iango94/Electrocardiografia1/DocumentosAdicionales/Presentacion.pptx

## Slide 2

## ECG sin filtros externos (centrado a la media)

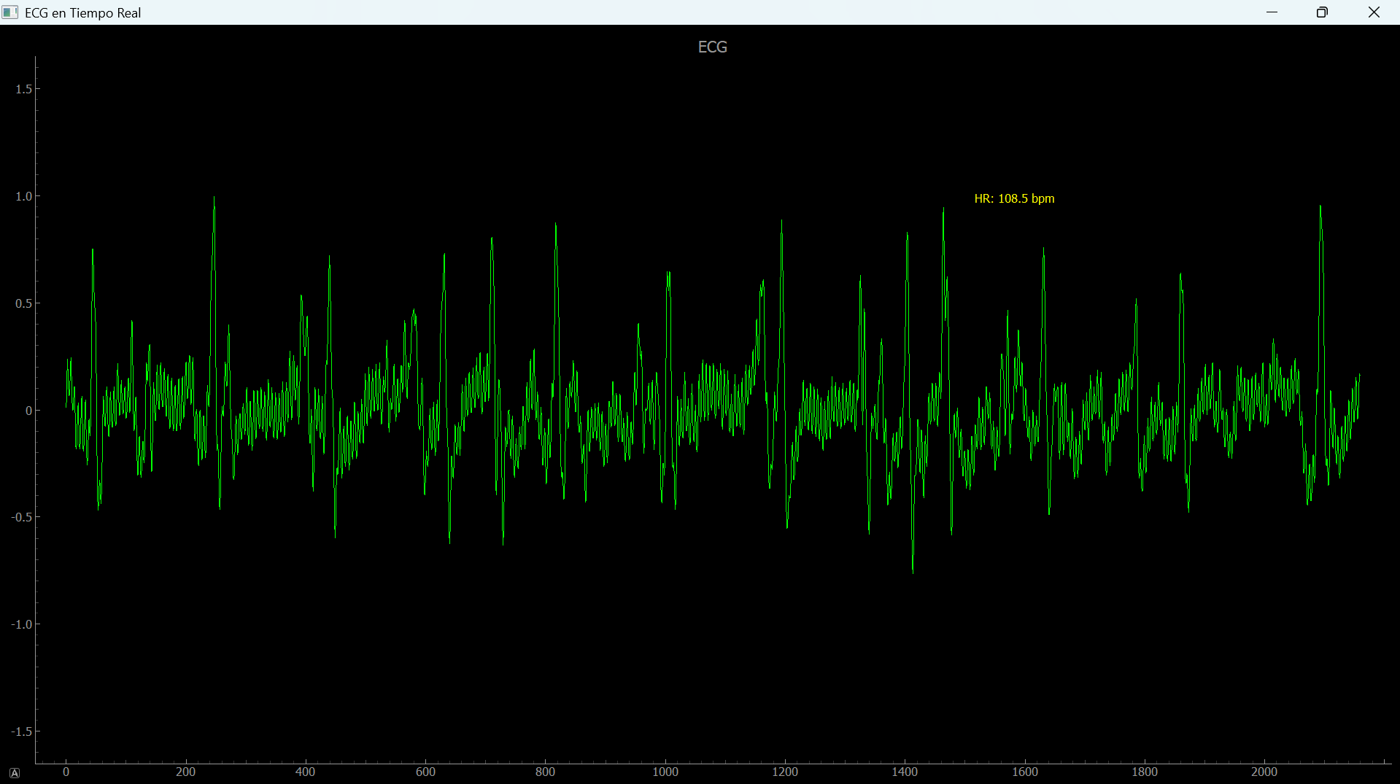
[picture p1: figure]

Derivación I

## Sin filtros de software (centrado a la media)

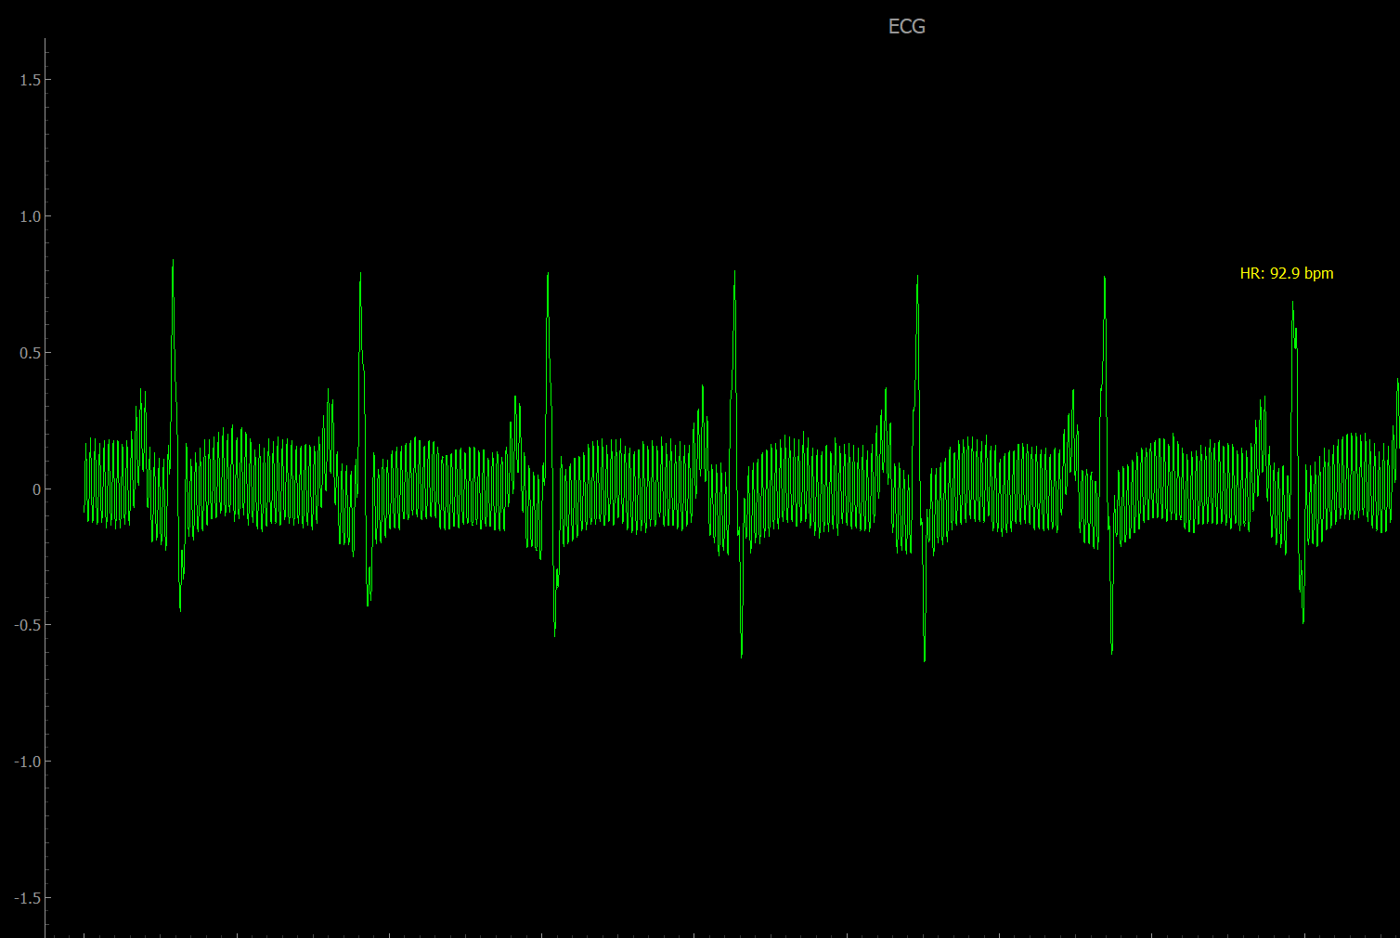
[picture p2: figure]

Derivación I

## ECG front-end (AD8232)

- Amplificador de instrumentación 1:1000
- Filtro de modo común
- Filtro pasabanda (0,5-50Hz)
- Salida analógica (0-3.3V)

## Arduino Nano

- Placa de desarrollo programable
- Convertidor analógico-digital
- Interfaz serial con PC (USB)
- Envía los voltajes analógicos de 0-3,3v de salida del AD8232, al PC 360 veces por segundo como un entero positivo entre 0-1023 (10 bits)

## Slide 7

## Procesamiento en software

1. Se recibe la señal por el puerto serie
2. Se realiza un filtro digital pasa-altas con corte en 0.5Hz (elimina ruido muscular y reparación)
3. Se realiza un filtro digital pasa-bajas con corte en 50Hz (elimina ruido AC y radiofrecuencias)
4. Se normaliza a la media (centra los valores en el promedio acumulado de las medidas)
5. Se analiza la onda para encontrar picos y calcular FC e intervalos.
6. Se grafican los valores digitales (voltajes instantáneos) en el tiempo como una línea continua (simulando la lectura analógica).
7. OPCIONAL: Se imprime la señal en una cuadricula estandarizada, se indica la FC e intervalos; y se guarda como PDF.

## Posición electrodos para derivación I (ECG 3E)

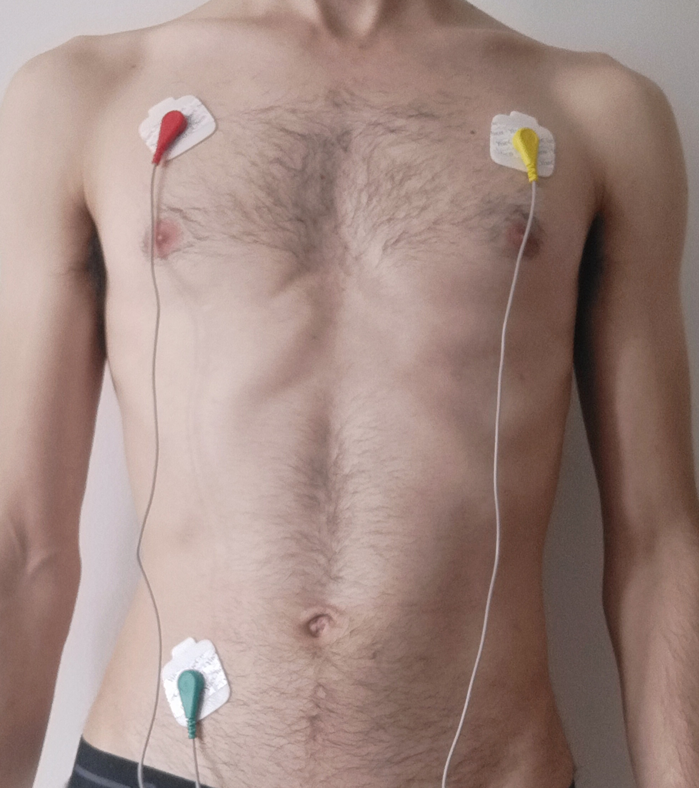
[picture p3: figure]

- Verde: Equipotencialización y modo común.
- Rojo: Electrodo (-)
- Amarillo: Electrodo (+)
- Para la demostración usamos la derivación II (ECG 3E)
EL CIRCUITO TIENE COMO SALIDA LA DIFERENCIA DE VOLTAJES ENTRE LOS ELECTRODOS ROJO Y AMARILLO, DESPUES DE AMPLIFICADA.

## Salida derivación II con todos los filtros

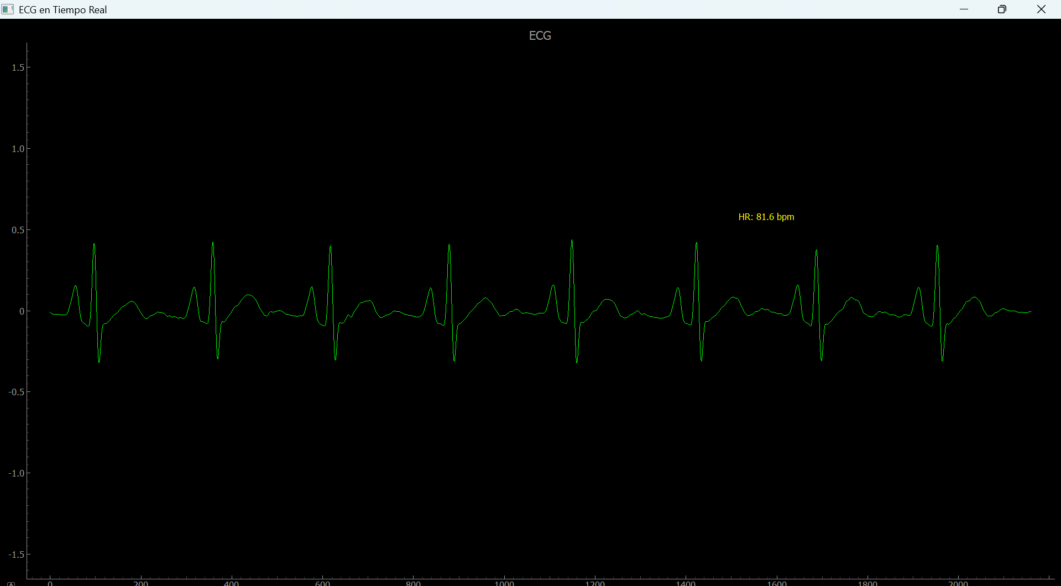
[picture p4: figure]

Derivación II

## Salida derivación II en cuadricula estandar

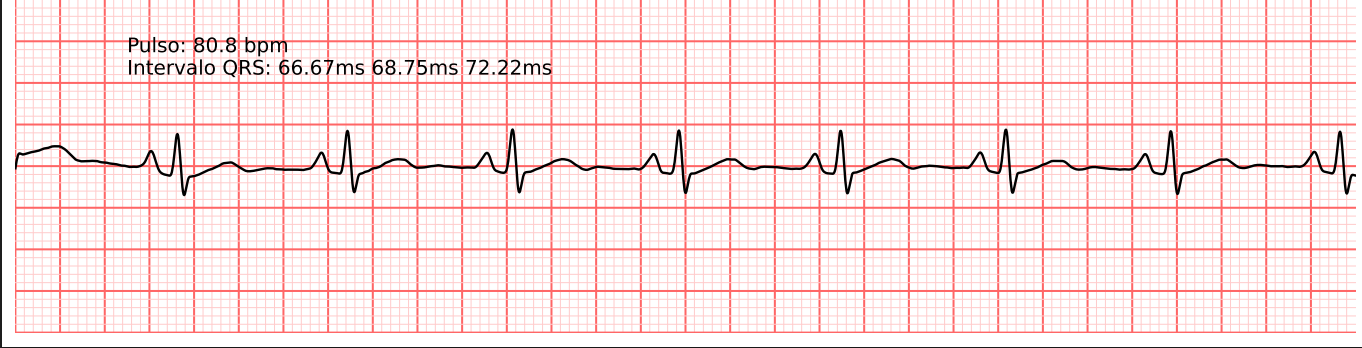
[picture p5: figure]

Derivación II

## Slide 12

## La importancia electrocardiograma

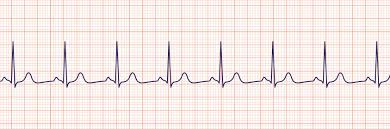
[picture p6: figure]

ECG Normal: ritmo sinusal

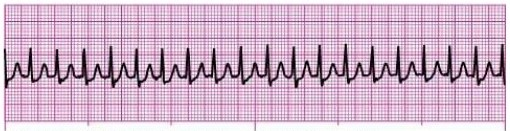
[picture p7: figure]

Taquicardia Supraventricular

- Estos 2 ritmos tienen los mismos síntomas (cuando el paciente esta consiente).
- La taquicardia supraventricular es una urgencia medica normalmente benigna.
- Torsades de Points es un ritmo mortal en cuestión de minutos.

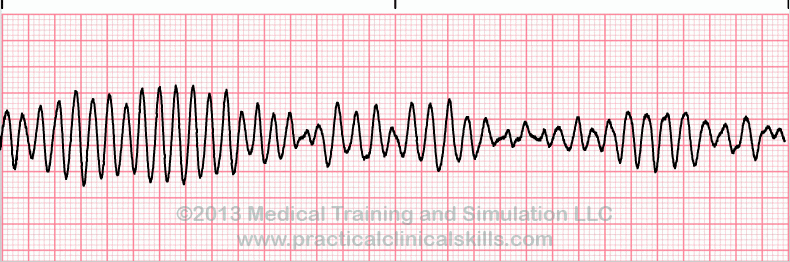
[picture p8: figure]

Torsades de Pontes (V-tac)
