iango94/Electrocardiografia1/ECG_Presentacion final tentativa.pdf

Problemática (Hanna)

- Principal causa de Muerte
- Muchas prevenibles con atención medica oportuna y tratamiento prehospitalario adecuado
- Mencionar los objetivos y el RDS.
- Solución de problemas (tema secundario)

Diseño analógico (Laura)

- Que es el ECG y que representa una derivación.
- Pasos:
- Restar potenciales
- Amplificar
- Filtrar
- Volver a amplificar
- Convertir a digital
- Casos especiales:
- WCT: promedio de RA, LA y LL, punto isoeléctrico para precordiales.
- RLD: cancelación activa de ruido y referencia a tierra.

Diseño digital y software (Ian)

- Conversión analógica digital
- Captura de datos (ECG + Cuestionario)
- Delineación del ECG (el algoritmo de Pan-Tompkins y sus mejoras)
- Algoritmo infartos AHA

Problema 1: (Angel)

- Señal vs ruido

Problema 2: (Camilo)

- Deriva de línea base (respiración + potencial de media celda)

Conclusiones (Alejandro)
