iango94/Electrocardiografia1/esquematicosCircuitos/Imagen_DerivacionII.png

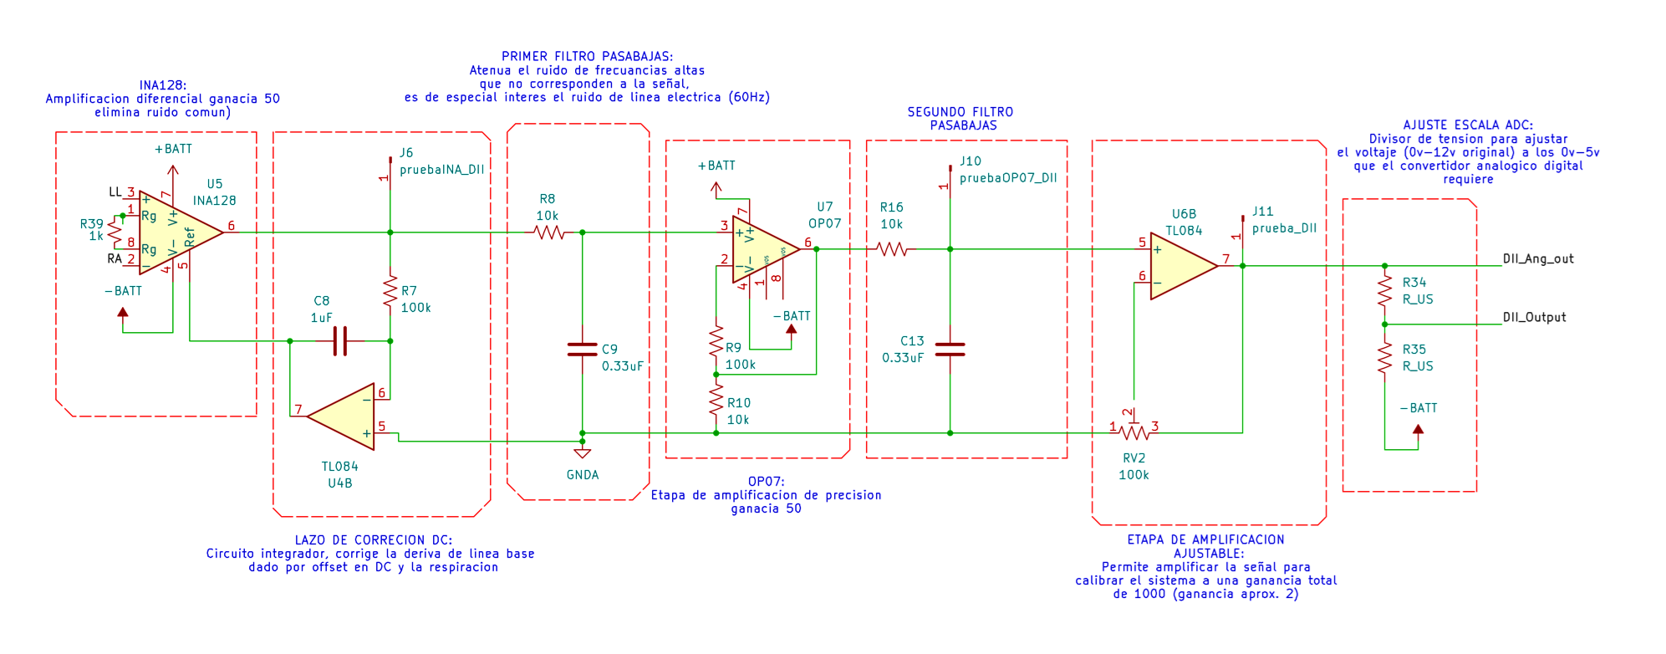
esquematicosCircuitos/Imagen_DerivacionII.png
