iango94/Electrocardiografia1/ECGs/ReporteECG_PresentacionClase.pdf

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

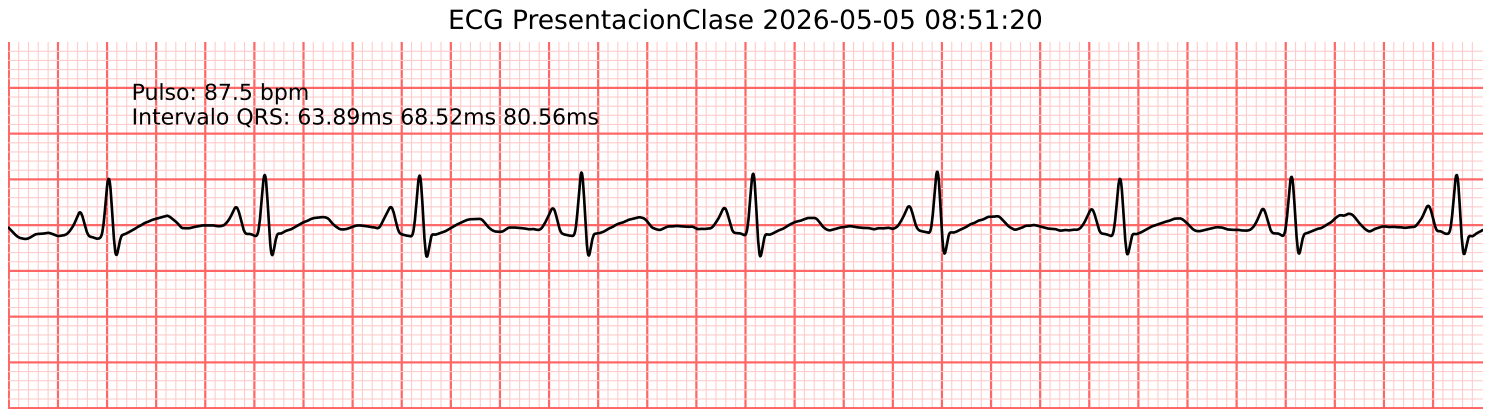
[picture p10: page 1]
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
