iango94/Electrocardiografia1/esquematicosCircuitos/Esquematico_DII_subsucciones.pdf

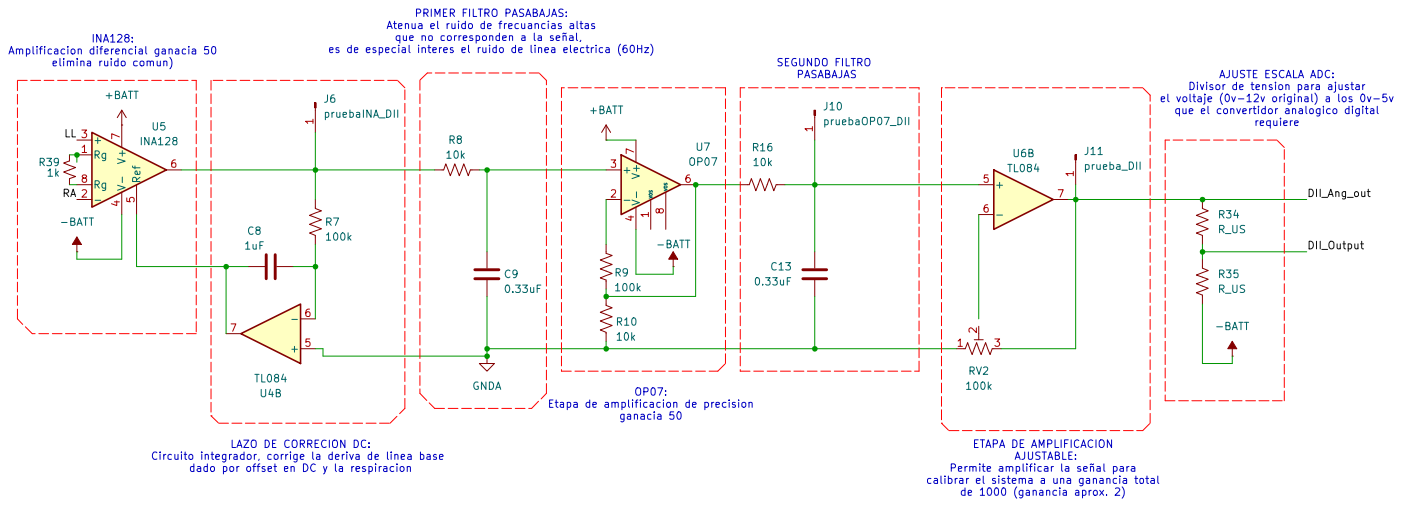
[picture p11: page 1]
