iango94/Electrocardiografia1/esquematicosCircuitos/Esquematico_final.pdf

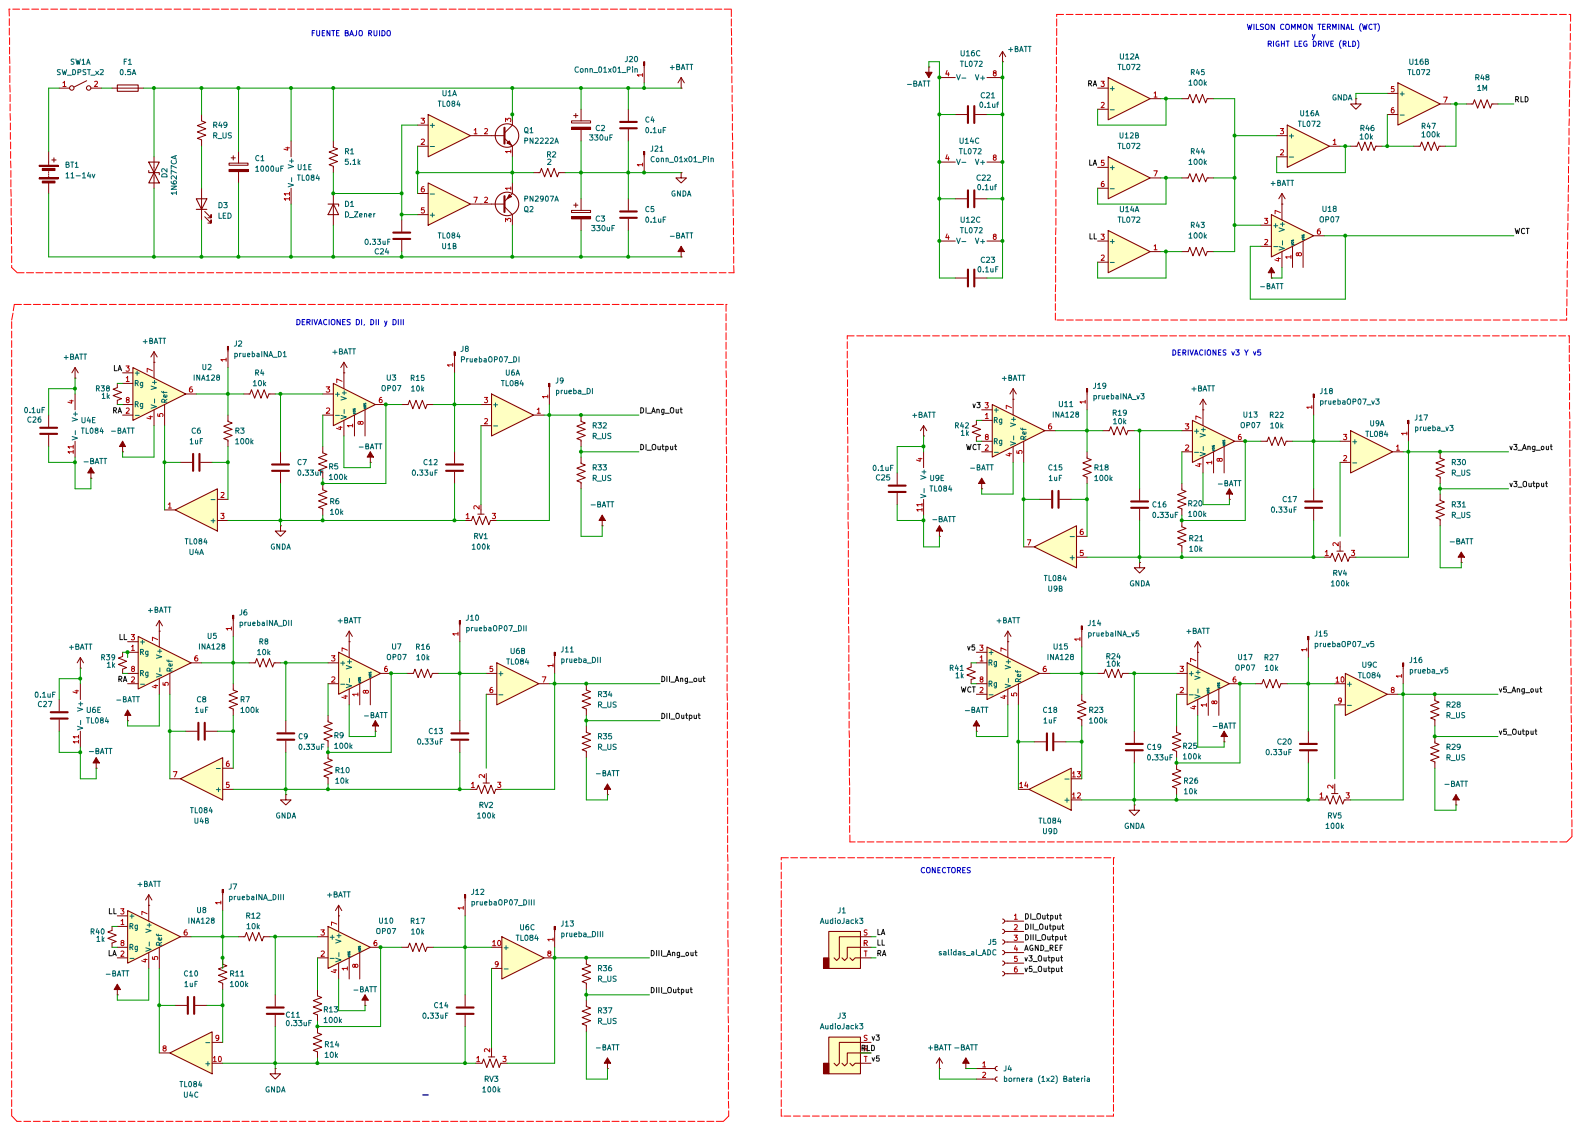
[picture p12: page 1]
