iango94/Electrocardiografia1/(commit log)

2026-04-29 Subiendo README y programa lector de ECG por serial
2026-05-05 Cambios para presentar sistema en clase
2026-05-20 carga codigo arduino
2026-05-20 documento con los calculos de las derivaciones
2026-05-20 agregado recurso inversion de electrodos
2026-06-08 codigo raspberry
2026-06-10 lista materiales
